HybridThingsLab/robodada/docs/robo03.jpg

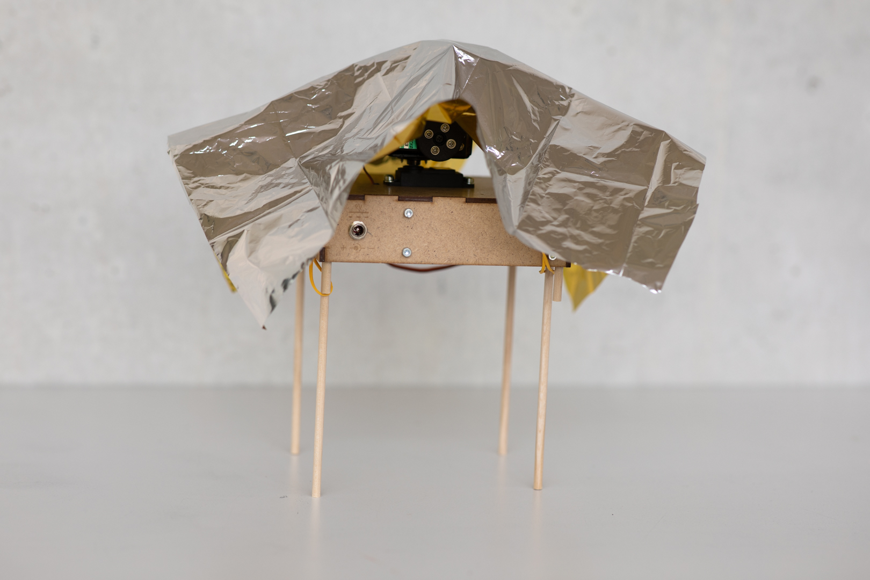
docs/robo03.jpg
