HybridThingsLab/robodada/(commit log)

2020-03-10 control servos with nodemcu
2020-03-10 fit to work with the servo library, value name determined by html class name
2020-06-19 switch to osc float values and map them with a custom float map function
2020-07-14 update Arduino code to work with latest version ArduinoOSC update ArduinoOSC to version > 0.3.7
2020-08-12 switched from lib osc to node-osc
2020-08-12 node-osc chooses send port randomly(?) -> fixed port again
    [osc_servo.ino]
2020-08-27 Added scaffold for robo chooser overlay, moved buttons
2020-09-03 Fixed insertion of robot name in main model after claim
2020-09-10 servo mount svg files
2020-09-12 Hid wave button on roboChooserOverlay
2020-09-14 change label button to 'webcam'
2020-09-14 change label button to 'cam' again
2020-09-15 bugfix because wave button not visible
2021-01-21 Bump socket.io from 2.3.0 to 2.4.0 in /Serverland
    Bumps [socket.io](https://github.com/socketio/socket.io) from 2.3.0 to 2.4.0.
    - [Release notes](https://github.com/socketio/socket.io/releases)
    - [Changelog](https://github.com/socketio/socket.io/blob/2.4.0/CHANGELOG.md)
    - [Commits](https://github.com/socketio/socket.io/compare/2.3.0...2.4.0)
2021-07-13 Update README.md
    hint NodeMCU Arduino IDE
2021-10-11 change servo pins to '5' and '4' instead 'D1' and 'D2'
2022-02-15 Bump copy-props from 2.0.4 to 2.0.5 in /Userland
    Bumps [copy-props](https://github.com/gulpjs/copy-props) from 2.0.4 to 2.0.5.
    - [Release notes](https://github.com/gulpjs/copy-props/releases)
    - [Changelog](https://github.com/gulpjs/copy-props/blob/master/CHANGELOG.md)
    - [Commits](https://github.com/gulpjs/copy-props/compare/2.0.4...2.0.5)
    ---
    updated-dependencies:
    - dependency-name: copy-props
    dependency-type: indirect
    ...
2022-08-09 establish socketio connections via the certified url
2022-08-11 shift emotion wrapper up for camera mode
2022-10-30 Bump socket.io-parser and browser-sync in /Userland
    Bumps [socket.io-parser](https://github.com/socketio/socket.io-parser) to 4.2.1 and updates ancestor dependency [browser-sync](https://github.com/BrowserSync/browser-sync). These dependencies need to be updated together.
    Updates `socket.io-parser` from 3.2.0 to 4.2.1
    - [Release notes](https://github.com/socketio/socket.io-parser/releases)
    - [Changelog](https://github.com/socketio/socket.io-parser/blob/main/CHANGELOG.md)
    - [Commits](https://github.com/socketio/socket.io-parser/compare/3.2.0...4.2.1)
    Updates `browser-sync` from 2.26.7 to 2.27.10
    - [Release notes](https://github.com/BrowserSync/browser-sync/releases)
    - [Changelog](https://g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
2022-11-09 Bump socket.io-parser from 3.3.0 to 3.3.3 in /Serverland
    Bumps [socket.io-parser](https://github.com/socketio/socket.io-parser) from 3.3.0 to 3.3.3.
    - [Commits](https://github.com/socketio/socket.io-parser/compare/3.3.0...3.3.3)
    - dependency-name: socket.io-parser
    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
2022-11-23 Bump engine.io and browser-sync in /Userland
    Bumps [engine.io](https://github.com/socketio/engine.io) to 6.2.1 and updates ancestor dependency [browser-sync](https://github.com/BrowserSync/browser-sync). These dependencies need to be updated together.
    Updates `engine.io` from 3.2.1 to 6.2.1
    - [Release notes](https://github.com/socketio/engine.io/releases)
    - [Changelog](https://github.com/socketio/engine.io/blob/main/CHANGELOG.md)
    - [Commits](https://github.com/socketio/engine.io/compare/3.2.1...6.2.1)
    - [Changelog](https://github.com/BrowserSync/browser-sync/blob/master/CH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
2022-11-23 Bump engine.io and socket.io in /Serverland
    Bumps [engine.io](https://github.com/socketio/engine.io) to 3.6.1 and updates ancestor dependency [socket.io](https://github.com/socketio/socket.io). These dependencies need to be updated together.
    Updates `engine.io` from 3.4.0 to 3.6.1
    - [Commits](https://github.com/socketio/engine.io/compare/3.4.0...3.6.1)
    Updates `socket.io` from 2.3.0 to 2.5.0
    - [Changelog](https://github.com/socketio/socket.io/blob/main/CHANGELOG.md)
    - [Commits](https: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
2023-06-21 UI changes: smaller robot buttons in robot chooser to handle many robots better, new alignment strategy for emotion buttons to better support smaller 16:9 resolutions
2023-06-21 Bump socket.io-parser and socket.io in /Userland
    Bumps [socket.io-parser](https://github.com/socketio/socket.io-parser) and [socket.io](https://github.com/socketio/socket.io). These dependencies needed to be updated together.
    Updates `socket.io-parser` from 4.2.1 to 4.2.4
    - [Commits](https://github.com/socketio/socket.io-parser/compare/4.2.1...4.2.4)
    Updates `socket.io` from 4.5.1 to 4.6.2
    - [Comm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
2023-06-21 Bug chasing: Make emotion buttons wrap 3 to 4, make smileys scale, minor padding changes
